ktemkin-archive/JD-beacon-board/enclosure_hardware/mechanical_drawing.pdf

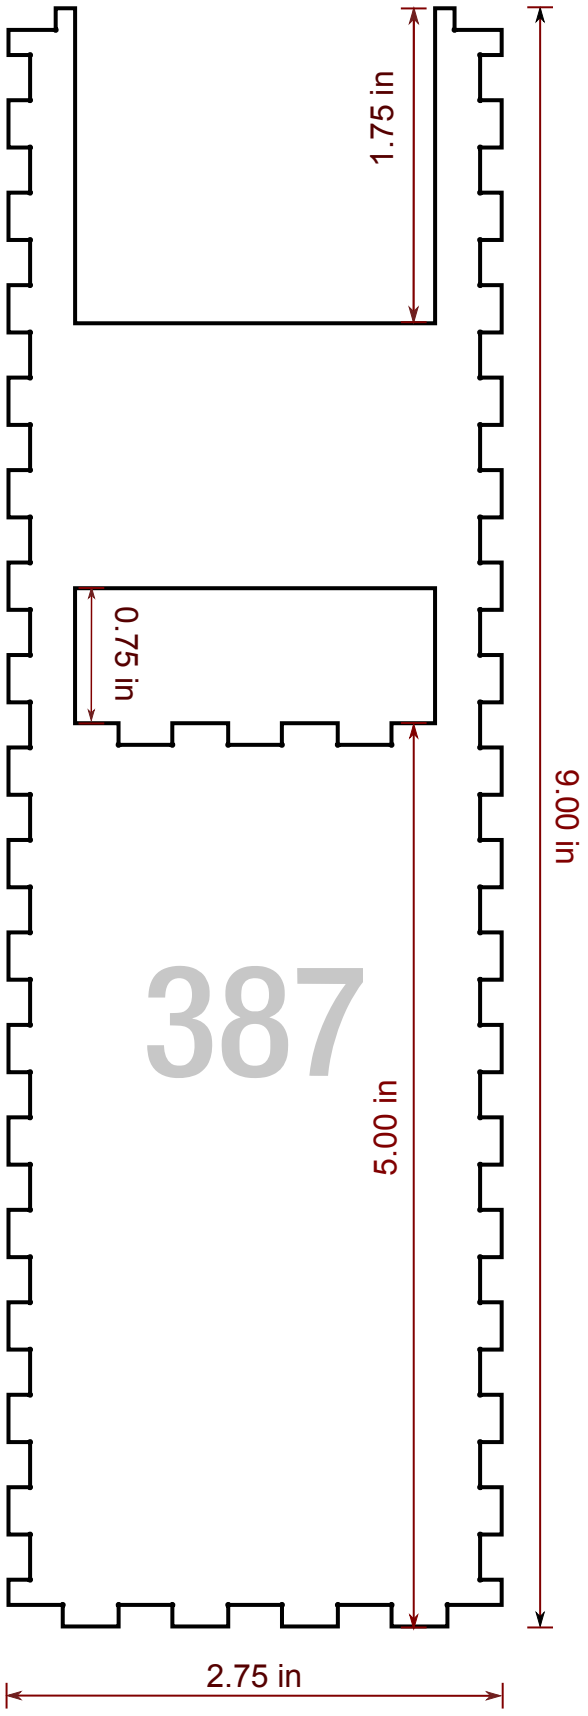
[picture p1: figure]

## BEACON TOWER

# SIDE VIEW

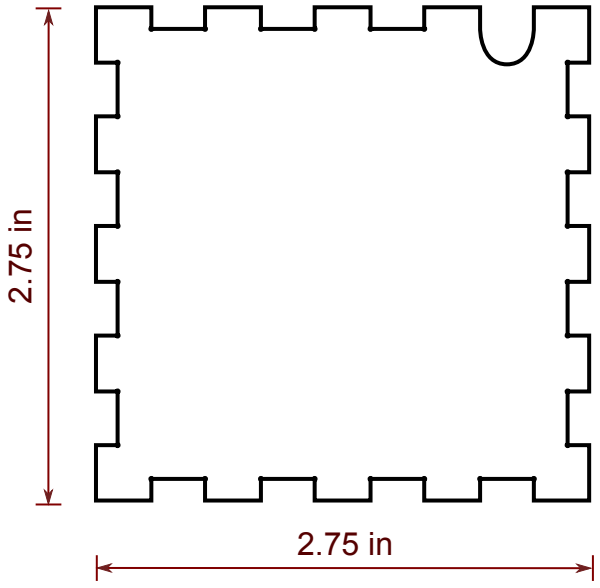
[picture p2: figure]

## BEACON TOWER

# TOP VIEW

This mechanical drawing is to scale, and has been created from the actual lasercut design drawings, which are available on the GitHub page for the Junior Design beacons.

Note that the edges of the beacon towers themselves are not jagged-- the marks on the edge of the tower drawing to the left snap together with the other set of pieces (not shown), which have the same dimensions, but complementary side cutouts.
