ktemkin-archive/JD-beacon-board/gameplay/figures/beacon_tower.pdf

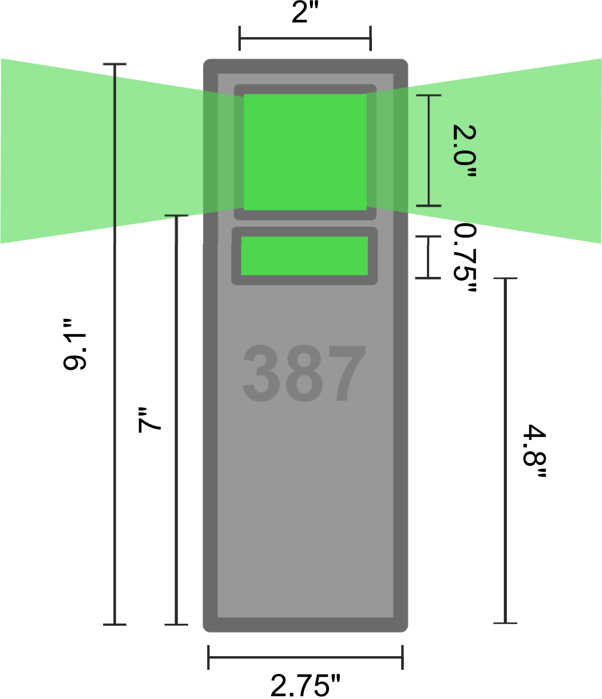
[picture p3: page 1]

2.75"

2"

0.75"

9.1"

4.8"

7"
