ktemkin-archive/JD-beacon-board/gameplay/competition_1.png

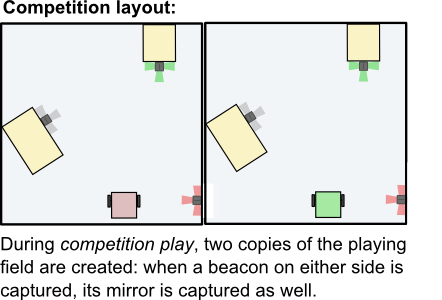
gameplay/competition_1.png
