ktemkin-archive/JD-beacon-board/gameplay/field_overview.png

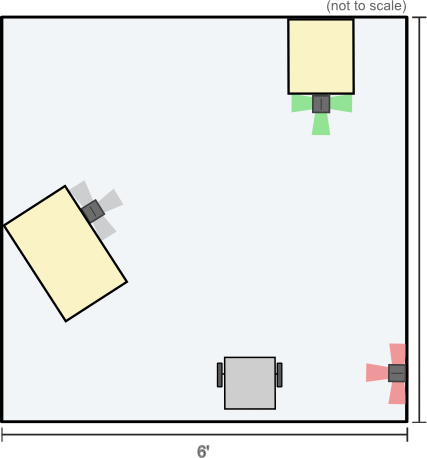
gameplay/field_overview.png
