ktemkin-archive/JD-beacon-board/pcb_hardware/renders/bottom_render.png

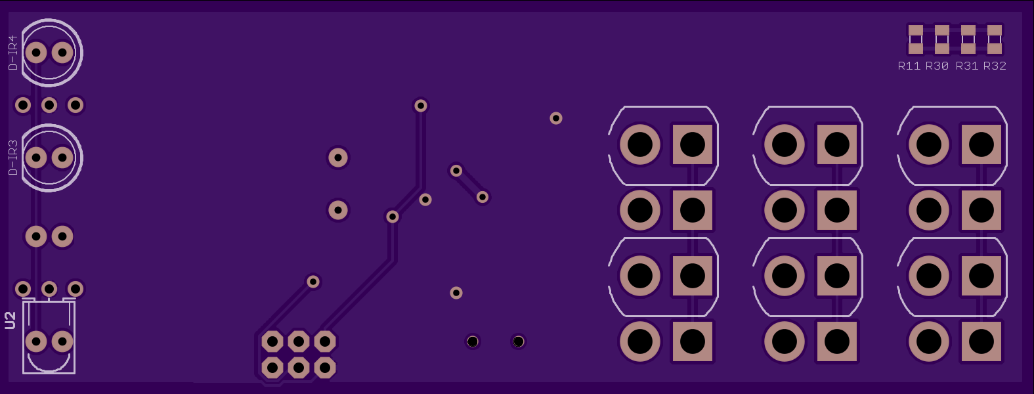
pcb_hardware/renders/bottom_render.png
