ktemkin-archive/JD-beacon-board/pcb_hardware/renders/top_render.png

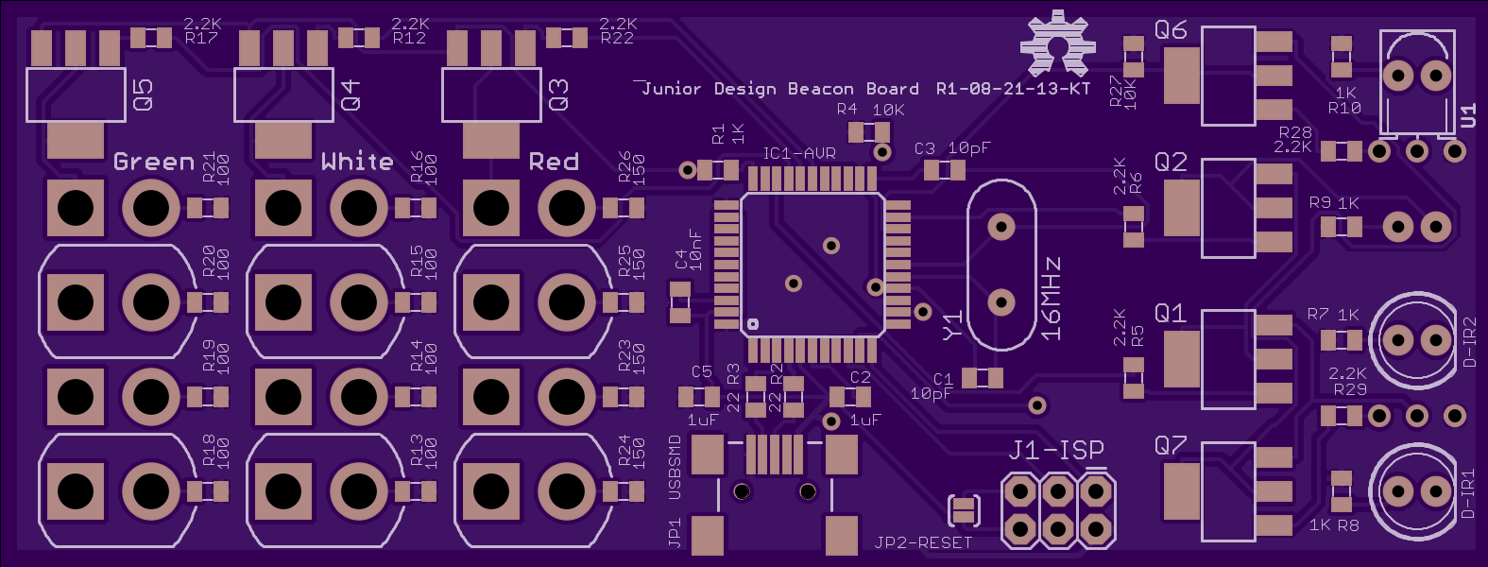
pcb_hardware/renders/top_render.png
