ktemkin-archive/JD-beacon-board/pcb_hardware/beacon_board.pdf

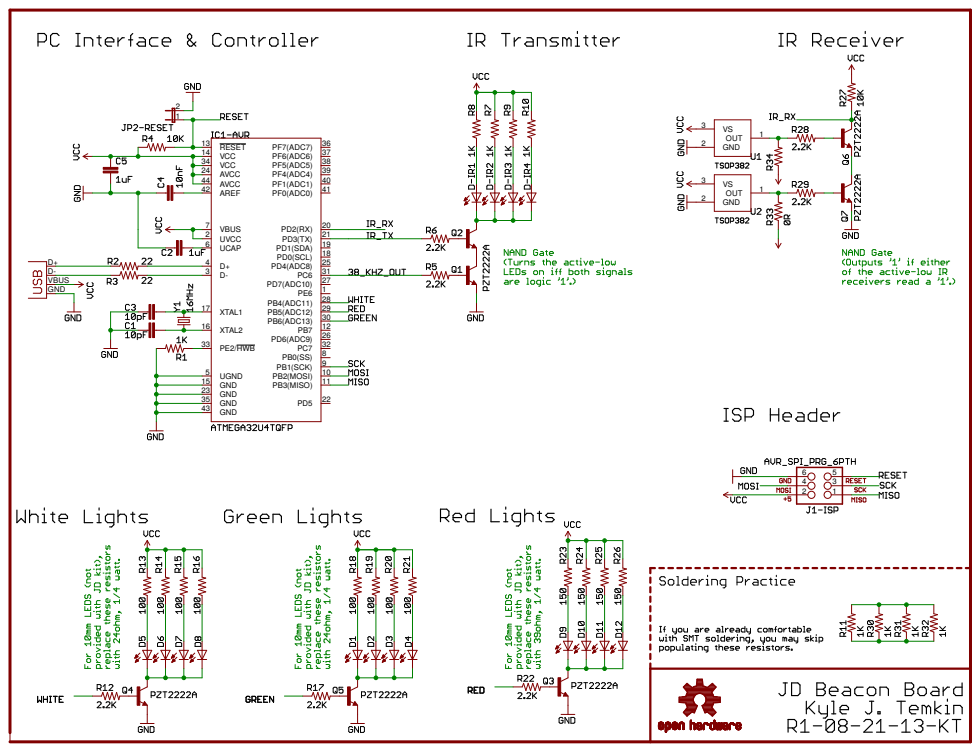
[picture p8: page 1]
