ktemkin-archive/JD-beacon-board/gameplay/figures/field_overview.pdf

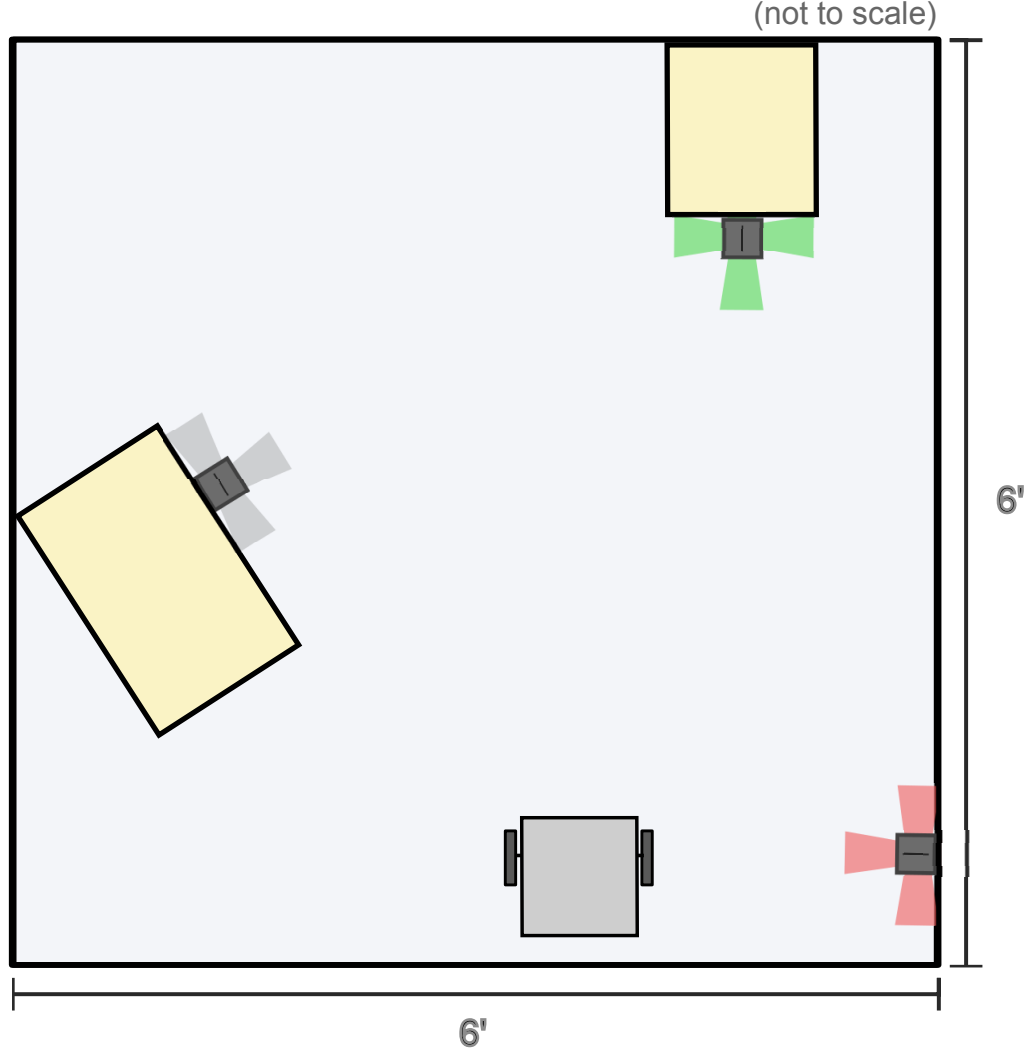
[picture p9: page 1]

(not to scale)
