ktemkin-archive/JD-beacon-board/pcb_hardware/simulations/receiver.asc

Q1: npn; 2N2222
Q2: npn; 2N2222
R1: res; 30K
R2: res; 10K
R3: res; 500R
R4: res; 2.2K
V1: voltage; 5V
V2: voltage; 0V
Named nets: VOUT, VBASE, 0
TSOP32838
When using a receiver with an internal pull-up as its network, R4 should be unnecessary.
V2 simulates the value of the rx'd IR.
