ktemkin-archive/JD-beacon-board/pcb_hardware/beacon_board.brd

## EAGLE design pcb_hardware/beacon_board.brd (2013-12-28)

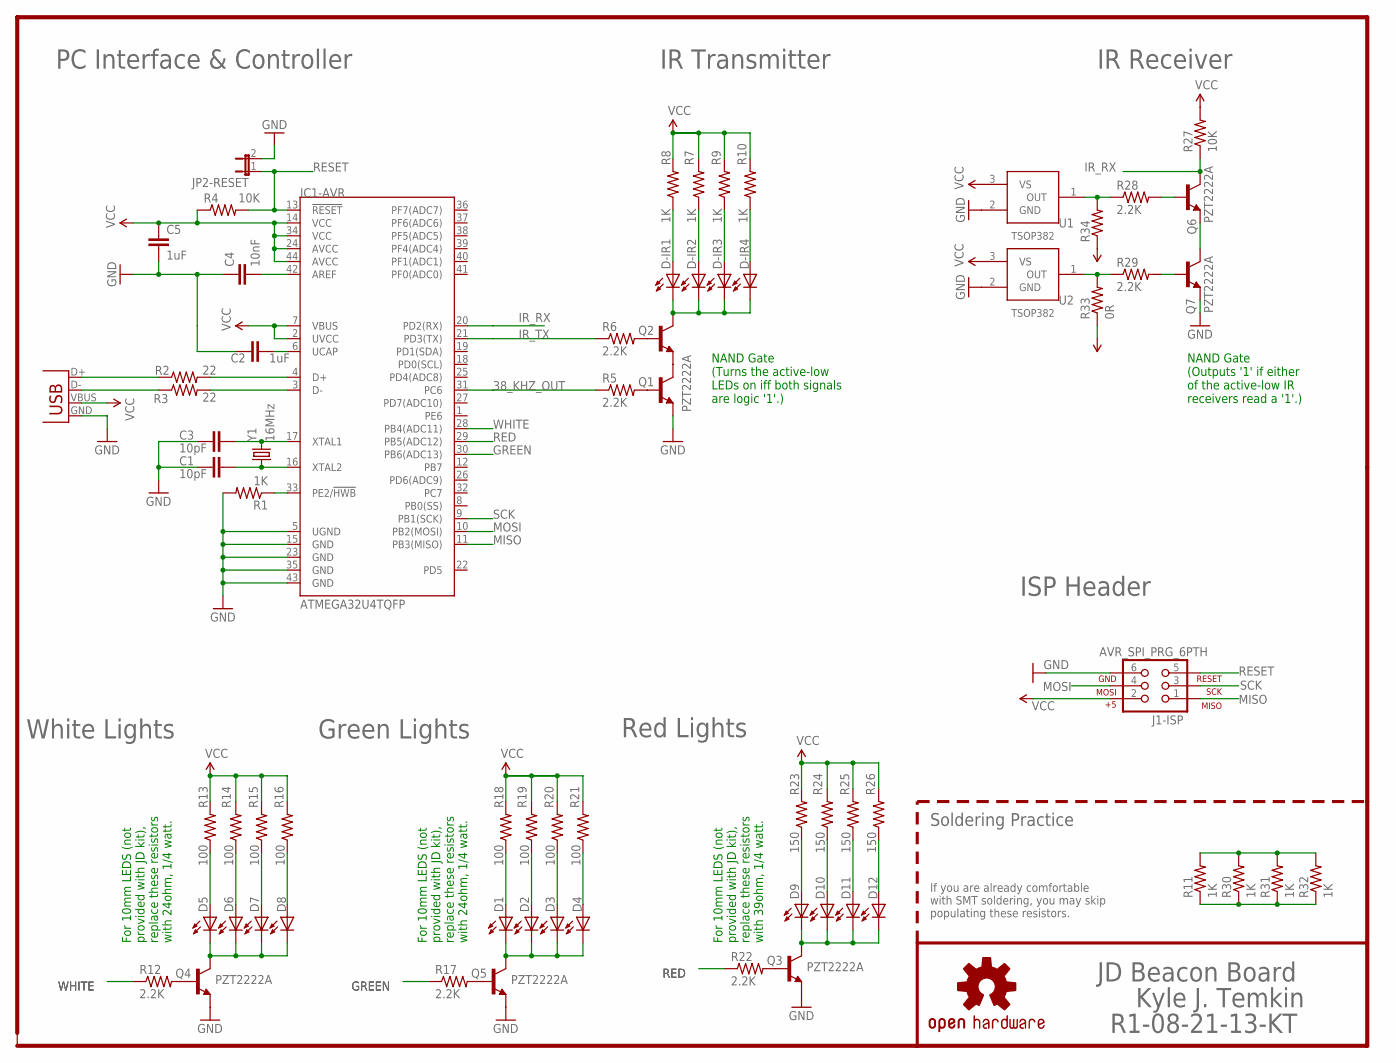
[picture p10: schematic beacon_board.sch]

Parts:
C1, C3: 10pF; 0805
C2, C5: 1uF; 0805
C4: 10nF; 0805
D1, D2, D3, D4, D5, D6, D7, D8, D9, D10, D11, D12: LED10MM
D-IR1, D-IR2, D-IR3, D-IR4: LED5MM
IC1-AVR: ATMEGA32U4TQFP; SPARKFUN-DIGITALIC_TQFP44
J1-ISP: AVR_SPI_PRG_6PTH; 2X3
JP1: USBSMD; USB-MINIB
JP2-RESET: JUMPER-2SMD-NO; SJ_2S-NO
LOGO1: OSHW-LOGOM; OSHW-LOGO-M
Q1, Q2, Q3, Q4, Q5, Q6, Q7: PZT2222A; SOT223
R1, R7, R8, R9, R10, R11, R30, R31, R32: 1K; 0805
R2, R3: 22; 0805
R4, R27: 10K; 0805
R5, R6, R12, R17, R22, R28, R29: 2.2K; 0805
R13, R14, R15, R16, R18, R19, R20, R21: 100; 0805
R23, R24, R25, R26: 150; 0805
R33: 0R; 0805
R34: RESISTOR0805-RES; 0805
U1, U2: TSOP382
U$1: BINGHAMTON-EECE-TEXT
Y1: 16MHz; HC49US

Connections:
38_KHZ_OUT: IC1-AVR.31 (PC6), R5.1
D1: D1.C, D2.C, D3.C, D4.C, Q5.2 (C), Q5.4 (C)
D2: D9.C, D10.C, D11.C, D12.C, Q3.2 (C), Q3.4 (C)
D9: D5.C, D6.C, D7.C, D8.C, Q4.2 (C), Q4.4 (C)
GND: C1.1, C2.1, C3.1, C4.1, C5.2, IC1-AVR.5 (UGND), IC1-AVR.15 (GND), IC1-AVR.23 (GND), IC1-AVR.35 (GND), IC1-AVR.43 (GND), J1-ISP.6, JP1.GND, JP2-RESET.2, Q1.3 (E), Q3.3 (E), Q4.3 (E), Q5.3 (E), Q7.3 (E), R1.2, U1.2 (GND), U2.2 (GND)
GREEN: IC1-AVR.30 (PB6(ADC13)), R17.1
IR_RX: IC1-AVR.20 (PD2(RX)), Q6.2 (C), Q6.4 (C), R27.1
IR_TX: IC1-AVR.21 (PD3(TX)), R6.1
MISO: IC1-AVR.11 (PB3(MISO)), J1-ISP.1
MOSI: IC1-AVR.10 (PB2(MOSI)), J1-ISP.4
unnamed: IC1-AVR.4 (D+), R2.2
unnamed: IC1-AVR.3 (D-), R3.2
unnamed: JP1.D+, R2.1
unnamed: JP1.D-, R3.1
unnamed: C2.2, IC1-AVR.6 (UCAP)
unnamed: C3.2, IC1-AVR.17 (XTAL1), Y1.2
unnamed: C1.2, IC1-AVR.16 (XTAL2), Y1.1
unnamed: IC1-AVR.33 (PE2/!HWB), R1.1
unnamed: Q4.1 (B), R12.2
unnamed: Q5.1 (B), R17.2
unnamed: C4.2, IC1-AVR.42 (AREF)
unnamed: Q2.1 (B), R6.2
unnamed: Q1.1 (B), R5.2
unnamed: Q1.2 (C), Q1.4 (C), Q2.3 (E)
unnamed: D-IR1.K (C), D-IR2.K (C), D-IR3.K (C), D-IR4.K (C), Q2.2 (C), Q2.4 (C)
unnamed: D-IR1.A, R8.1
unnamed: D1.A, R18.1
unnamed: D5.A, R13.1
unnamed: D-IR3.A, R9.1
unnamed: D7.A, R15.1
unnamed: D3.A, R20.1
unnamed: Q3.1 (B), R22.2
unnamed: D9.A, R23.1
unnamed: D11.A, R25.1
unnamed: Q6.3 (E), Q7.2 (C), Q7.4 (C)
unnamed: R28.1, R34.2, U1.1 (OUT)
unnamed: Q6.1 (B), R28.2
unnamed: Q7.1 (B), R29.2
unnamed: R29.1, R33.2, U2.1 (OUT)
unnamed: R11.2, R30.2, R31.2, R32.2
unnamed: R11.1, R30.1, R31.1, R32.1
RED: IC1-AVR.29 (PB5(ADC12)), R22.1
RESET: IC1-AVR.13 (!RESET), J1-ISP.5, JP2-RESET.1, R4.2
SCK: IC1-AVR.9 (PB1(SCK)), J1-ISP.3
VCC: C5.1, IC1-AVR.2 (UVCC), IC1-AVR.7 (VBUS), IC1-AVR.14 (VCC), IC1-AVR.24 (AVCC), IC1-AVR.34 (VCC), IC1-AVR.44 (AVCC), J1-ISP.2, JP1.VBUS, R4.1, R7.2, R8.2, R9.2, R10.2, R13.2, R14.2, R15.2, R16.2, R18.2, R19.2, R20.2, R21.2, R23.2, R24.2, R25.2, R26.2, R27.2, R33.1, R34.1, U1.3 (VS), U2.3 (VS)
VCC1: D-IR2.A, R7.1
VCC2: D6.A, R14.1
VCC3: D-IR4.A, R10.1
VCC4: D8.A, R16.1
VCC5: D2.A, R19.1
VCC6: D4.A, R21.1
VCC7: D10.A, R24.1
VCC8: D12.A, R26.1
WHITE: IC1-AVR.28 (PB4(ADC11)), R12.1

Notes on the sheet:
IR Transmitter
PC Interface & Controller
For 10mm LEDS (not provided with JD kit), replace these resistors with 24ohm, 1/4 watt.
For 10mm LEDS (not provided with JD kit), replace these resistors with 39ohm, 1/4 watt.
NAND Gate (Turns the active-low LEDs on iff both signals are logic '1'.)
NAND Gate (Outputs '1' if either of the active-low IR receivers read a '1'.)
IR Receiver
ISP Header
Red Lights
Green Lights
White Lights
JD Beacon Board
Kyle J. Temkin
R1-08-21-13-KT
Soldering Practice
If you are already comfortable with SMT soldering, you may skip populating these resistors.

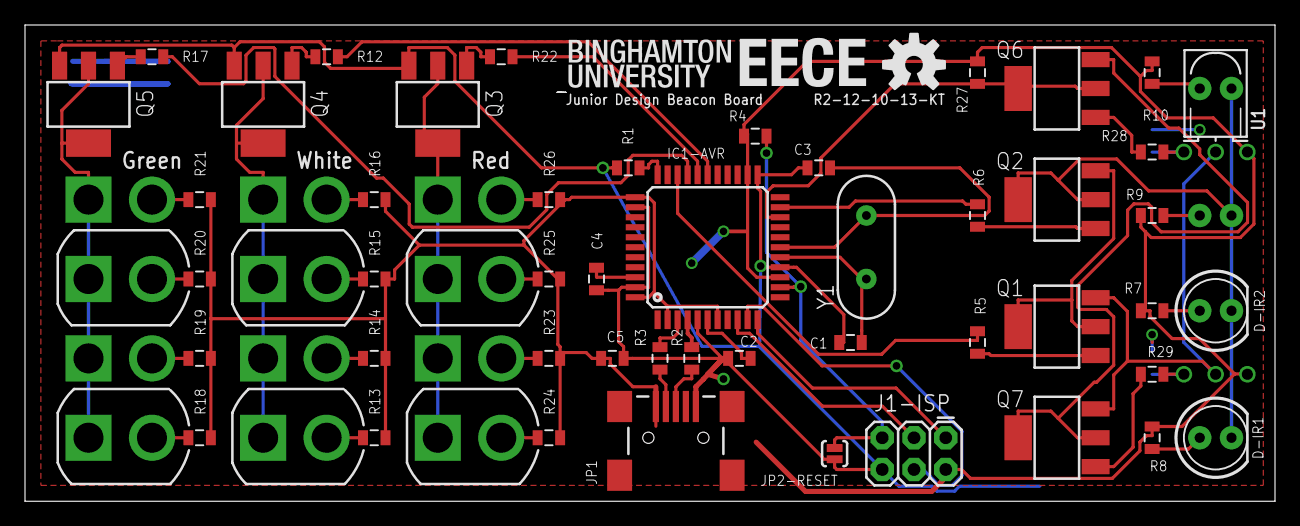
[picture p11: board beacon_board.brd from above]

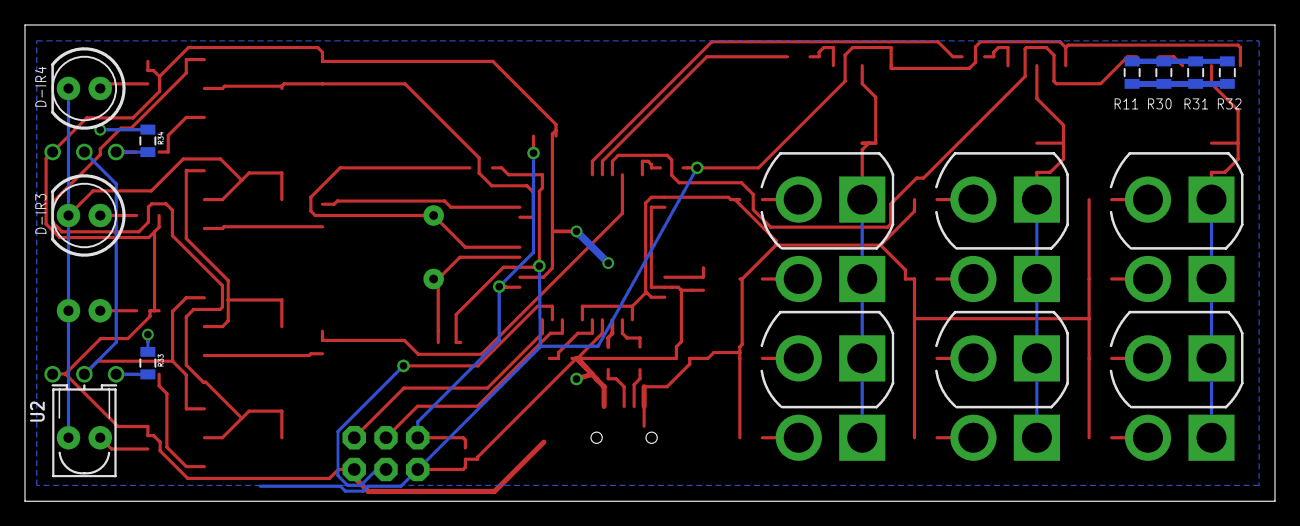
[picture p12: board beacon_board.brd from below]

Board: 2 copper layers, 100.0 x 38.1 mm, 71 parts (15 on the bottom side), 54 nets.
