ktemkin-archive/JD-beacon-board/board_software/timers.c

/**
 * timers.c
 * Timer functions for the JD Beacon Board; which control precisely timed
 * events (such as the dimming of LEDs, and the trigger to transmit over IR.)
 *
 * The MIT License (MIT)
 *
 * Copyright (c) 2014 Kyle J. Temkin <ktemkin@binghamton.edu>
 * Copyright (c) 2014 Binghamton University
 *
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
 * THE SOFTWARE IS PROVIDED "AS IS", WITHOUT WARRANTY OF ANY KIND, EXPRESS OR
 * IMPLIED, INCLUDING BUT NOT LIMITED TO THE WARRANTIES OF MERCHANTABILITY,
 * FITNESS FOR A PARTICULAR PURPOSE AND NONINFRINGEMENT. IN NO EVENT SHALL THE
 * AUTHORS OR COPYRIGHT HOLDERS BE LIABLE FOR ANY CLAIM, DAMAGES OR OTHER
 * LIABILITY, WHETHER IN AN ACTION OF CONTRACT, TORT OR OTHERWISE, ARISING FROM,
 * OUT OF OR IN CONNECTION WITH THE SOFTWARE OR THE USE OR OTHER DEALINGS IN
 * THE SOFTWARE.
 */

#include "timers.h"

// Declare each of the "tick handlers", which point to functions
// which will execute at predefined intervals (150Hz and 1Hz).
TimerEventHandler fast_tick_handler  = 0;
TimerEventHandler slow_tick_handler  = 0;

/**
 * Specifies how many fast ticks should pass before a slow tick is
 * triggered. For approximately one second, use 156,200.
 */
static const uint16_t fast_ticks_per_slow_tick = 15620UL;


/**
 * Set up each of the internal hardware timers for use by the timer module.
 * This enables use of the various timer functions provided below.
 *
 * This function is designed to be idempotent-- that is, you can call it
 * multiple times with no ill effects. This means that multiple modules which
 * depend on timer functions can all call this initialization function.
 */
void set_up_timers() {

  //Set up the timer that's used to determine brightness.
  TCCR1B |= ((0 << CS12) | (0 << CS11) | (1 << CS10) | (1 << WGM12));
  TIMSK1 |= (1 << OCIE1A);
  OCR1A = 1023;

}

/**
 * Registers a function which will be called whenever a "fast tick"
 * occurs. These events are called approximately 150 times per second.
 *
 * handler: A pointer to the function which will be called approximately
 *    150 times per second; or null to disable the fast tick handler.
 */
void register_fast_tick_handler(TimerEventHandler handler) {
  fast_tick_handler = handler;
}


/**
 * Registers a function which will be called whenever a "slow tick"
 * occurs. These events are called approximately once per second.
 *
 * handler: A pointer to the function which will be called approximately
 *    once per second; or null to disable the slow tick handler.
 */
void register_slow_tick_handler(TimerEventHandler handler) {
  slow_tick_handler = handler;
}


/**
 * Handler for the TIMER1 comparison event, which
 * occurs at about 156,200Hz.
 */
ISR(TIMER1_COMPA_vect) {

  //Stores the number of fast ticks which have occurred
  //since the last slow tick.
  static uint16_t fast_ticks = 0;

  //Count a single timer "fast tick",
  //which are used to generate the slow tick function.
  fast_ticks = (fast_ticks + 1) % fast_ticks_per_slow_tick;

  //If we have a valid fast tick handler, run it.
  if(fast_tick_handler) {
    fast_tick_handler();
  }

  //If our fast tick handler has just "wrapped around" to zero,
  //and we have a valid slow tick handler, run that handler.
  if(slow_tick_handler && !fast_ticks) {
    slow_tick_handler();
  }

}
