ktemkin-archive/JD-beacon-board/(commit log)

2013-08-17 Fixes state reversion glitch.
    -Fixes a glitch in which certain control packets incorrectly caused a state reversion,
    as a left-over piece of the data buffer was incorrectly interpreted as the current state.
    -Normalizes all "invalid beacon IDs" to the number 31, rather than the (equivalent) -1.
    [main.c]
2013-08-17 Implements (untested) board-side game logic
2013-08-19 Finish basic functionality of beacon board firmware
2013-08-19 Create initial incomplete work on PCB.
    [beacon_board.sch]
2013-08-20 Finish initial unchecked schematic capture
    [beacon_board.sch]
2013-08-20 Add scratch work for board layout
    [beacon_board.brd, beacon_board.sch]
2013-08-20 Complete alpha prototype for PCB
    [beacon_board.brd, beacon_board.sch, bill_of_materials.xlsx]
2013-08-20 Add renders of the prototype PCB
    [bill_of_materials.xlsx]
2013-08-21 Update bill of materials with part numbers
    [bill_of_materials.xlsx]
2013-08-21 Finish R1 of the beacon board PCB.
    [beacon_board.brd]
2013-10-06 Abstracts PWM timer functionality to a library.
    TIMER1 is currently used to drive LED dimming via PWM. Prior to this commit,
    it was coupled to the light module, and thus could not be used for other
    purposes.
    This commit decouples that module, allowing the timer to be used
    to generate an additional 1Hz signal (which will be useful in future
    IR communications procedures).
2013-10-06 Adds AVR-DFU options to the board software's makefile.
    These options allow the board to rapidly be programmed using the
    Device Firmware Upgrade mode.
2013-10-07 Add missing dependency to the beacon library.
    Adds the 'forwarable' module back to the beacon board library,
    which fixers a dependency issue when the libraries were called
    in a non-standard order.
2013-10-16 Finish initial beacon board and improve IR library
2013-12-04 add beacon enclosure
2013-12-13 Add parallell resistors for TSOP IR receivers
    [beacon_board.brd, beacon_board.sch]
2014-01-03 add new beacon images
    [beacon_board.brd, bill_of_materials.xlsx]
2014-01-03 update beacon board for final DFM steps
    [bill_of_materials.csv, bill_of_materials.xlsx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]
2014-01-27 [BOARD_SOFT] Add backend debug SPI interface.
2014-01-27 [PCB] Add SMD distribution sheet ("coupon").
2014-02-03 [PCB] Add initial assembly plan.
2014-02-15 [PCB] Updated documentation.
2014-04-13 [BOARD_SOFT] Changes the unused inputs so they're "pulled up" to VDD.
    This change reduces the device's power consumption.
2014-04-14 [BOARD_SOFT] Update the board software to provide diganostic information.
2014-04-14 [ENCLOSURE] Add mechanical drawings for the enclosure.
2014-04-14 [PCB] Update PCB assets.
2014-05-09 Add beacon freeze at the end of the competition.
    This makes for a more dramatic ending!
    [beacon_board.brd]
2014-05-15 [BOARD_SOFT] Minor pre-competition updates.
2015-04-21 Ensure devices are sorted by serial
